hparaujo2808/armariodispensario/armario/mapas/CHAPA_22.png

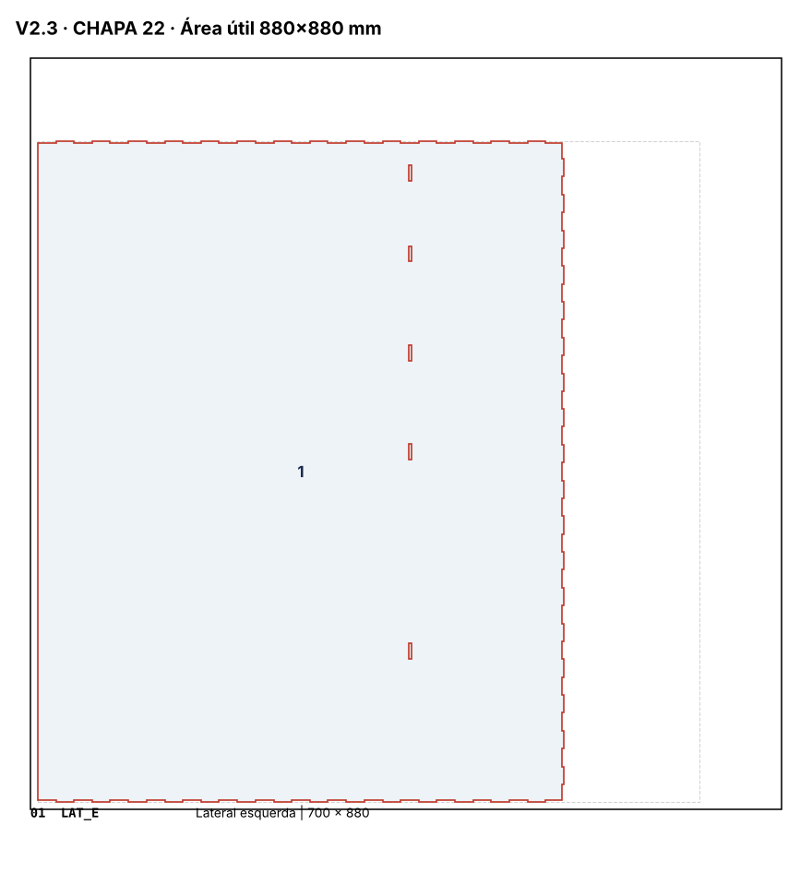
armario/mapas/CHAPA_22.png
