hparaujo2808/armariodispensario/armario/00_CUPOM_PORTA_NOMES.dxf

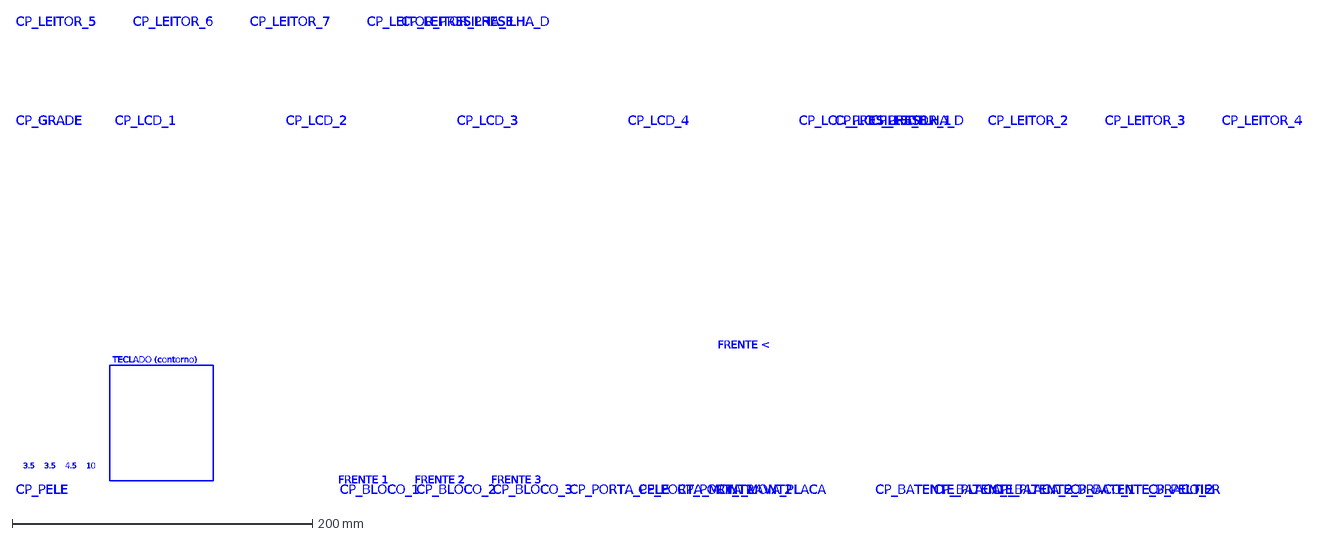
[picture p2: CAD file, 2026-10-23]
armario/00_CUPOM_PORTA_NOMES.dxf
CP_PELE
3.5
4.5
10
TECLADO (contorno)
CP_BLOCO_1
FRENTE 1
CP_BLOCO_2
FRENTE 2
CP_BLOCO_3
FRENTE 3
CP_PORTA_PELE
CP_PORTA_MONT1
CP_PORTA_MONT2
CP_TRAVA_PLACA
FRENTE <
CP_BATENTE_PLACA_1
CP_BATENTE_PLACA_2
CP_BATENTE_BRACO_1
CP_BATENTE_BRACO_2
CP_PELTIER
CP_GRADE
CP_LCD_1
CP_LCD_2
CP_LCD_3
CP_LCD_4
CP_LCD_PRESILHA_E
CP_LCD_PRESILHA_D
CP_LEITOR_1
CP_LEITOR_2
CP_LEITOR_3
CP_LEITOR_4
CP_LEITOR_5
CP_LEITOR_6
CP_LEITOR_7
CP_LEITOR_PRESILHA_E
CP_LEITOR_PRESILHA_D
