hparaujo2808/armariodispensario/armario/corte/CHAPA_24.dxf

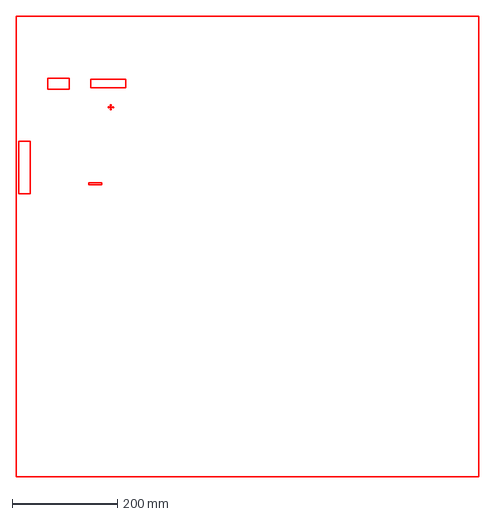
[picture p3: CAD file, 2026-10-23]
armario/corte/CHAPA_24.dxf
880.0 x 876.0 mm
