hparaujo2808/armariodispensario/armario/gravacao/CHAPA_26_NOMES.dxf

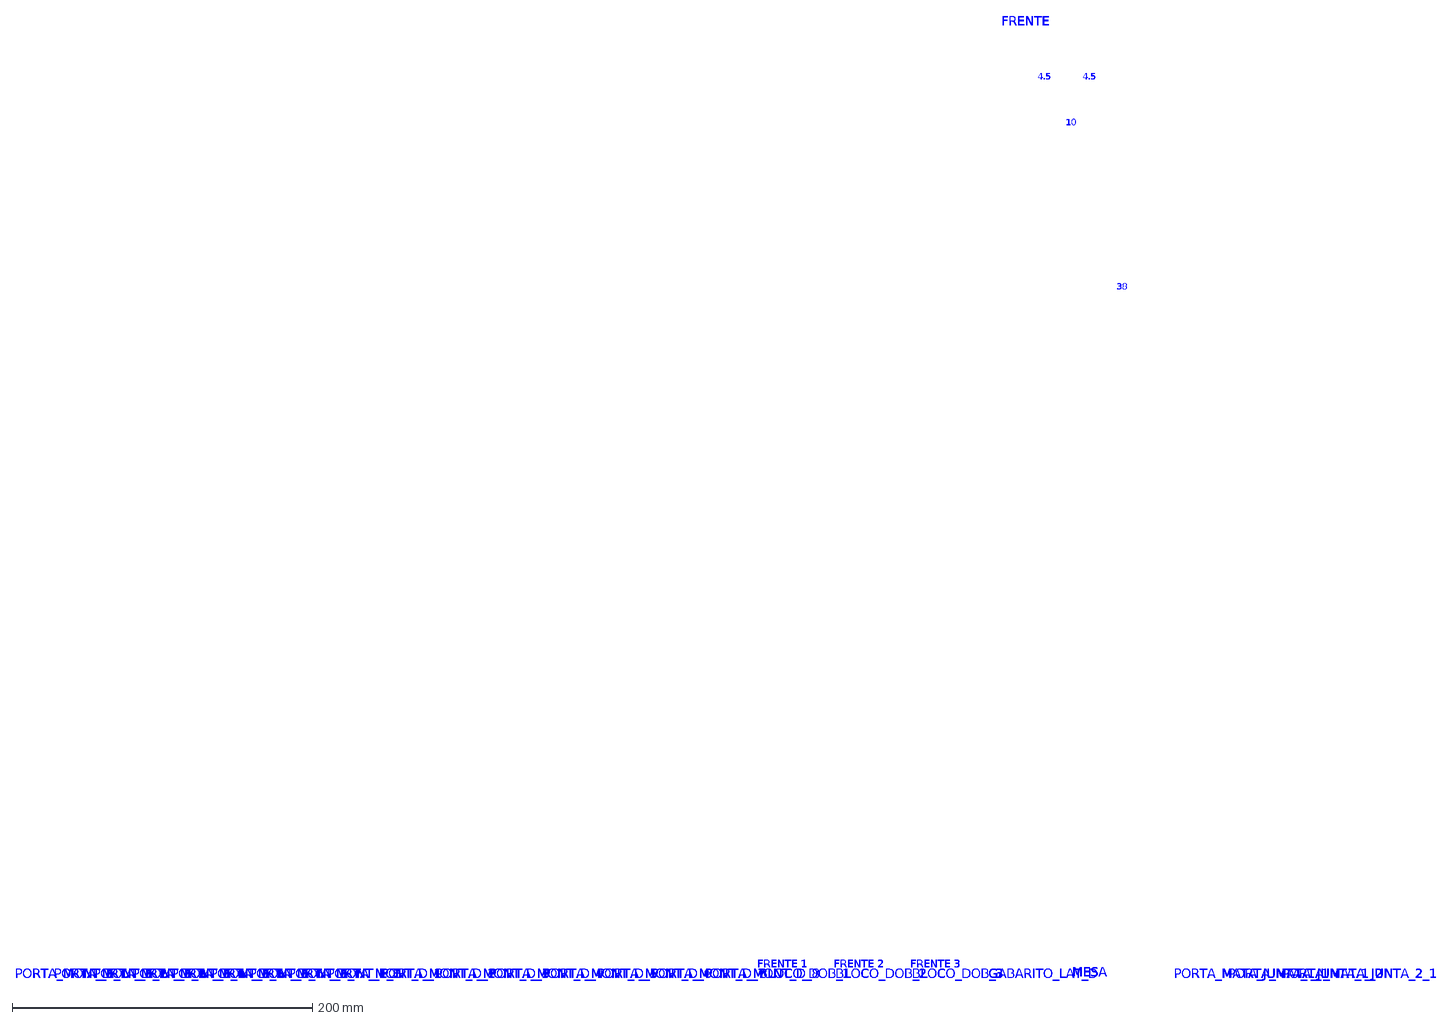
[picture p4: CAD file, 2026-10-23]
armario/gravacao/CHAPA_26_NOMES.dxf
PORTA_MONT_E_1
PORTA_MONT_E_2
PORTA_MONT_E_3
PORTA_MONT_E_4
PORTA_MONT_E_5
PORTA_MONT_E_6
PORTA_MONT_E_7
PORTA_MONT_E_8
PORTA_MONT_D_1
PORTA_MONT_D_2
PORTA_MONT_D_3
PORTA_MONT_D_4
PORTA_MONT_D_5
PORTA_MONT_D_6
PORTA_MONT_D_7
PORTA_MONT_D_8
BLOCO_DOB_1
FRENTE 1
BLOCO_DOB_2
FRENTE 2
BLOCO_DOB_3
FRENTE 3
GABARITO_LAT_D
4.5
10
38
FRENTE
MESA
PORTA_MATA_JUNTA_1_1
PORTA_MATA_JUNTA_1_2
PORTA_MATA_JUNTA_2_1
