hparaujo2808/armariodispensario/armario/00_CUPOM_PORTA_CORTE.dxf

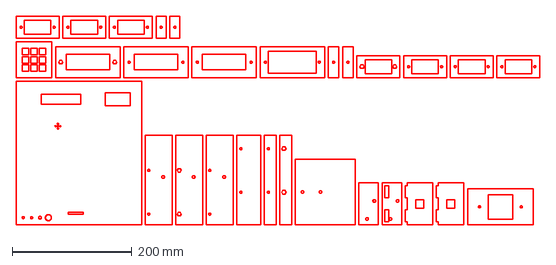
[picture p5: CAD file, 2026-10-23]
armario/00_CUPOM_PORTA_CORTE.dxf
876.0 x 349.0 mm
