hparaujo2808/armariodispensario/armario/corte/CHAPA_26.dxf

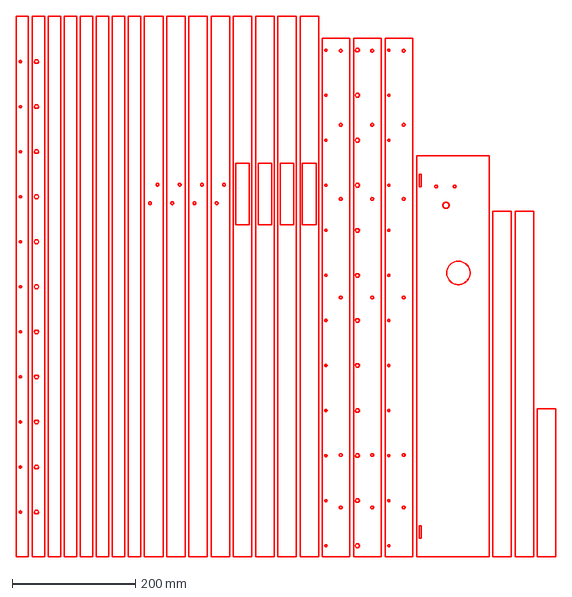
[picture p6: CAD file, 2026-10-23]
armario/corte/CHAPA_26.dxf
874.6 x 876.0 mm
