hparaujo2808/armariodispensario/armario/gravacao/CHAPA_25_NOMES.dxf

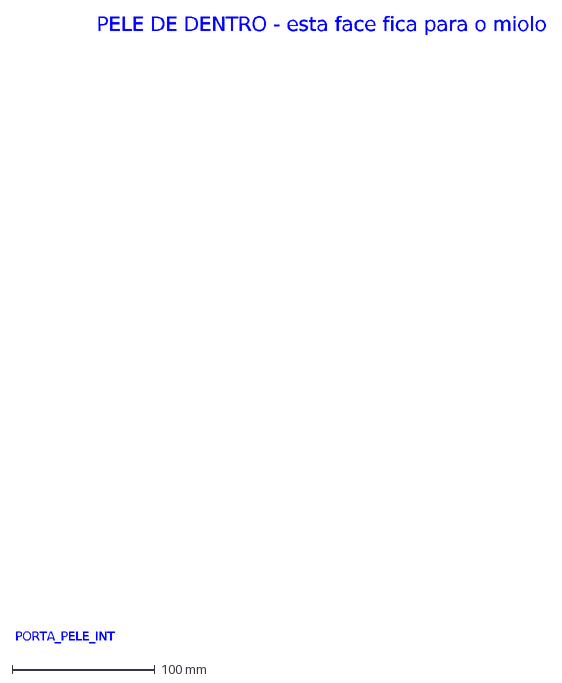
[picture p7: CAD file, 2026-10-23]
armario/gravacao/CHAPA_25_NOMES.dxf
PORTA_PELE_INT
PELE DE DENTRO - esta face fica para o miolo
