hparaujo2808/armariodispensario/armario/00_TESTES_CORTE.dxf

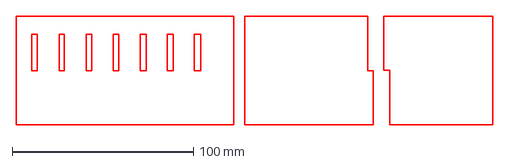
[picture p8: CAD file, 2026-10-22]
armario/00_TESTES_CORTE.dxf
263.0 x 60.0 mm
