hparaujo2808/armariodispensario/armario/corte/CHAPA_27.dxf

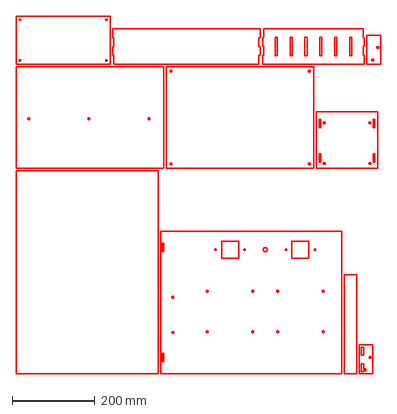
[picture p9: CAD file, 2026-10-23]
armario/corte/CHAPA_27.dxf
879.0 x 864.0 mm
