hparaujo2808/armariodispensario/armario/gravacao/CHAPA_24_NOMES.dxf

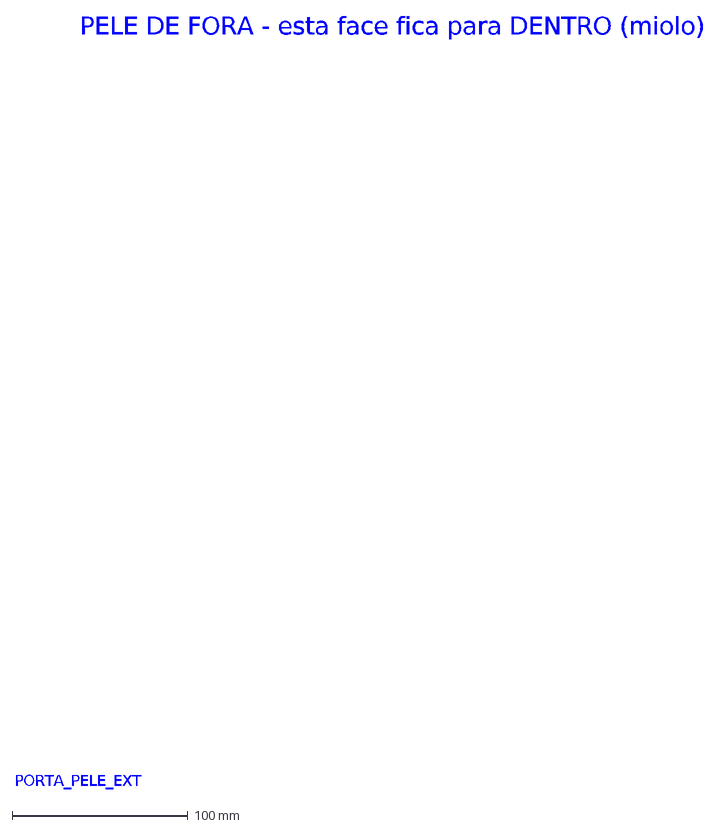
[picture p10: CAD file, 2026-10-23]
armario/gravacao/CHAPA_24_NOMES.dxf
PORTA_PELE_EXT
PELE DE FORA - esta face fica para DENTRO (miolo)
