hparaujo2808/armariodispensario/armario/00_TESTES_NOMES.dxf

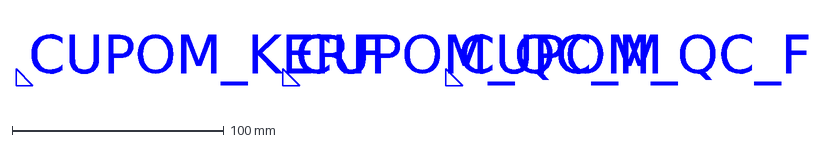
[picture p11: CAD file, 2026-10-22]
armario/00_TESTES_NOMES.dxf
CUPOM_KERF
CUPOM_QC_M
CUPOM_QC_F
