hparaujo2808/armariodispensario/armario/corte/CHAPA_25.dxf

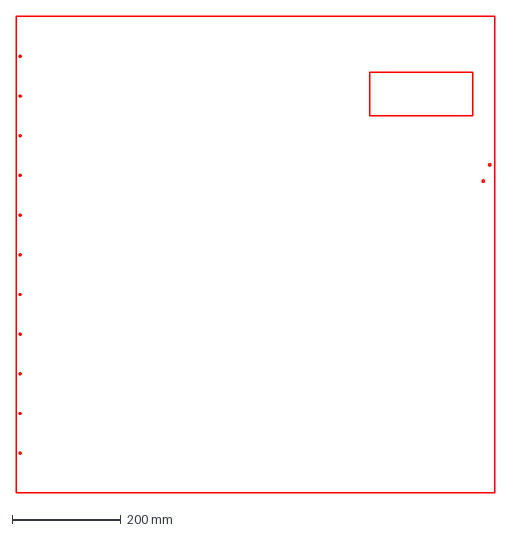
[picture p12: CAD file, 2026-10-23]
armario/corte/CHAPA_25.dxf
880.0 x 876.0 mm
