hparaujo2808/armariodispensario/armario/gravacao/CHAPA_28_NOMES.dxf

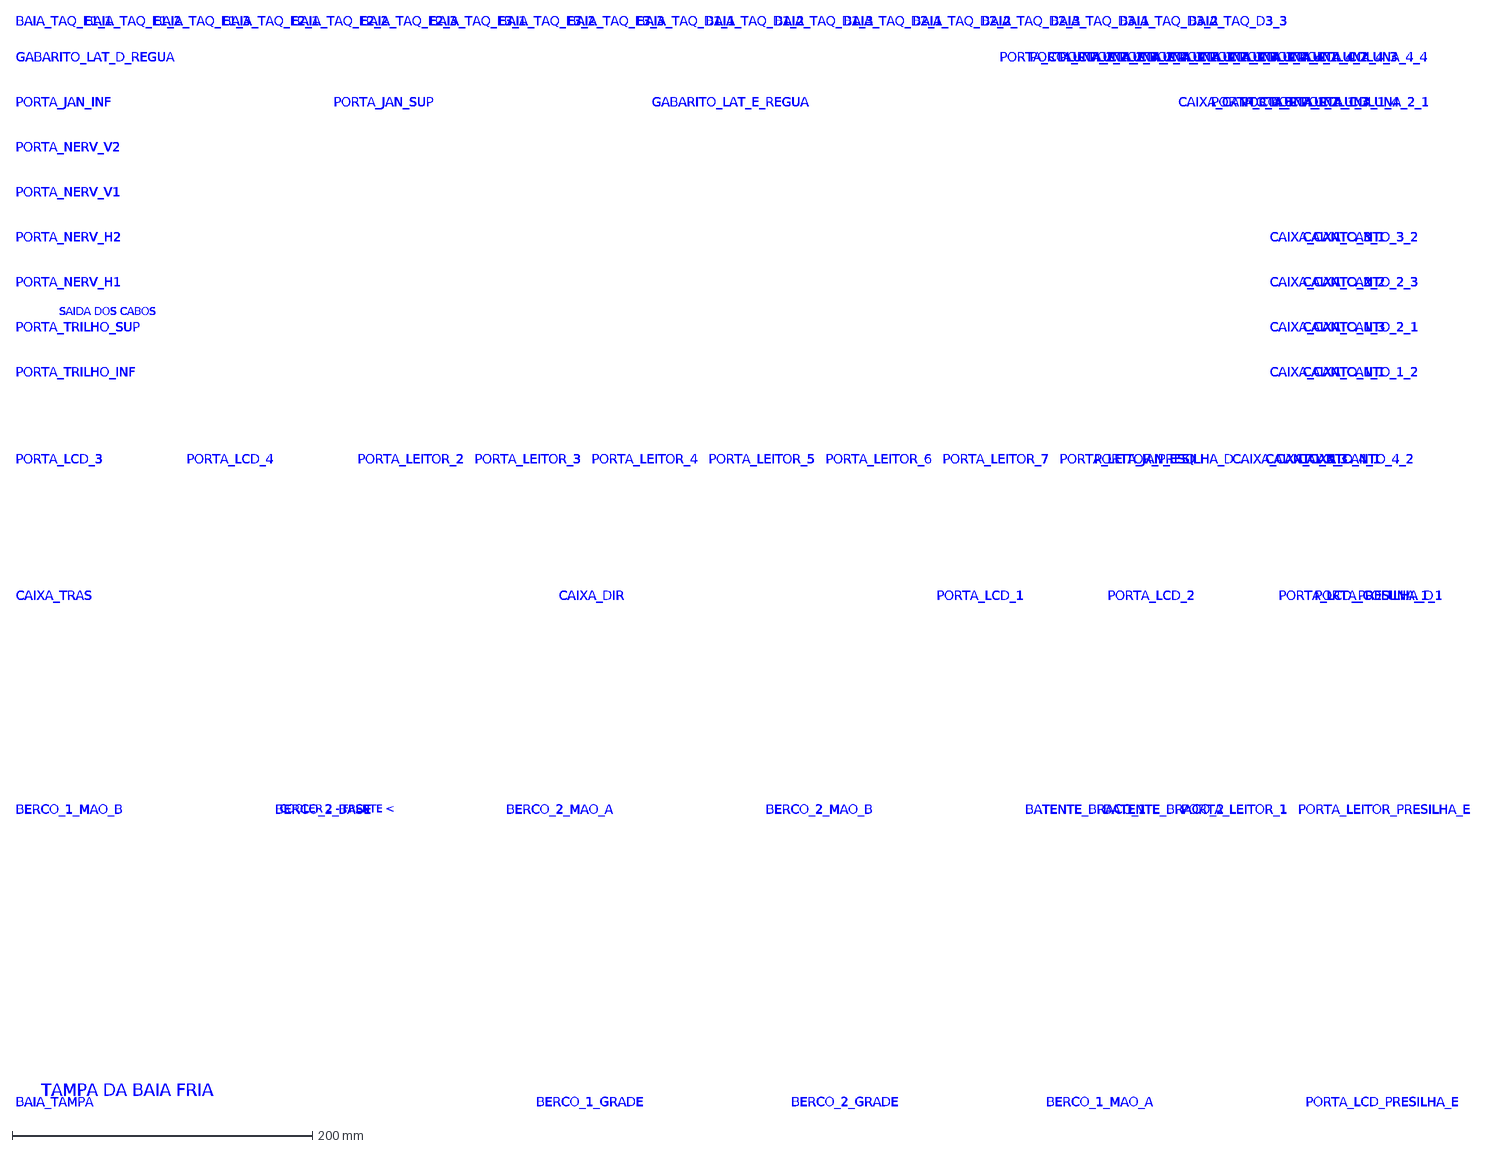
[picture p13: CAD file, 2026-10-23]
armario/gravacao/CHAPA_28_NOMES.dxf
BAIA_TAMPA
TAMPA DA BAIA FRIA
BERCO_1_GRADE
BERCO_2_GRADE
BERCO_1_MAO_A
BERCO_1_MAO_B
BERCO_2_BASE
COOLER 2 - FRENTE <
BERCO_2_MAO_A
BERCO_2_MAO_B
CAIXA_TRAS
CAIXA_DIR
BATENTE_BRACO_1
BATENTE_BRACO_2
PORTA_LCD_1
PORTA_LCD_2
PORTA_LCD_3
PORTA_LCD_4
PORTA_LCD_PRESILHA_E
PORTA_LCD_PRESILHA_D
PORTA_LEITOR_1
PORTA_LEITOR_2
PORTA_LEITOR_3
PORTA_LEITOR_4
PORTA_LEITOR_5
PORTA_LEITOR_6
PORTA_LEITOR_7
PORTA_LEITOR_PRESILHA_E
PORTA_LEITOR_PRESILHA_D
PORTA_TRILHO_INF
PORTA_TRILHO_SUP
SAIDA DOS CABOS
PORTA_NERV_H1
PORTA_NERV_H2
PORTA_NERV_V1
PORTA_NERV_V2
PORTA_JAN_INF
PORTA_JAN_SUP
PORTA_JAN_ESQ
GABARITO_LAT_E_REGUA
GABARITO_LAT_D_REGUA
CAIXA_CANTO_1_1
CAIXA_CANTO_1_2
CAIXA_CANTO_1_3
CAIXA_CANTO_2_1
CAIXA_CANTO_2_2
CAIXA_CANTO_2_3
CAIXA_CANTO_3_1
CAIXA_CANTO_3_2
CAIXA_CANTO_3_3
CAIXA_CANTO_4_1
CAIXA_CANTO_4_2
CAIXA_CANTO_4_3
PORTA_COLUNA_1_1
PORTA_COLUNA_1_2
PORTA_COLUNA_1_3
PORTA_COLUNA_1_4
PORTA_COLUNA_2_1
PORTA_COLUNA_2_2
PORTA_COLUNA_2_3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
