hparaujo2808/armariodispensario/armario/corte/CHAPA_28.dxf

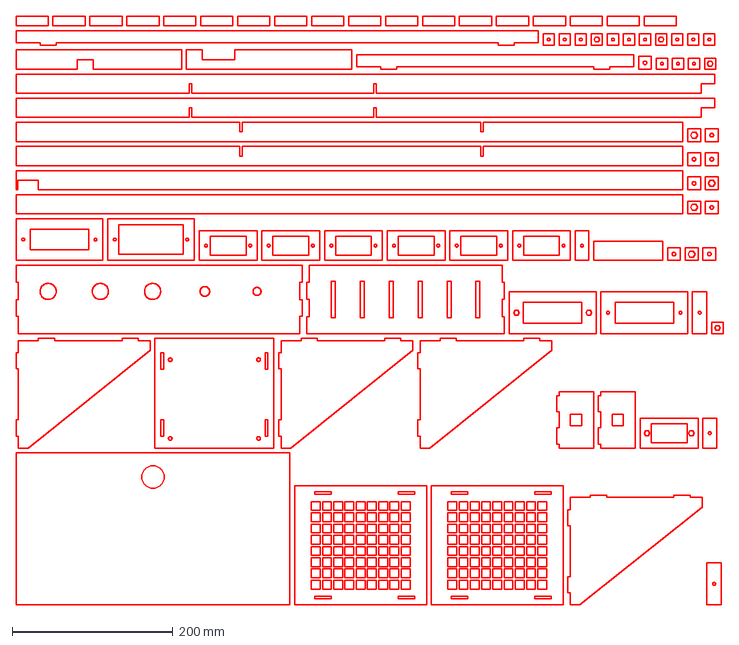
[picture p14: CAD file, 2026-10-23]
armario/corte/CHAPA_28.dxf
880.0 x 732.5 mm
