hparaujo2808/armariodispensario/armario/gravacao/CHAPA_27_NOMES.dxf

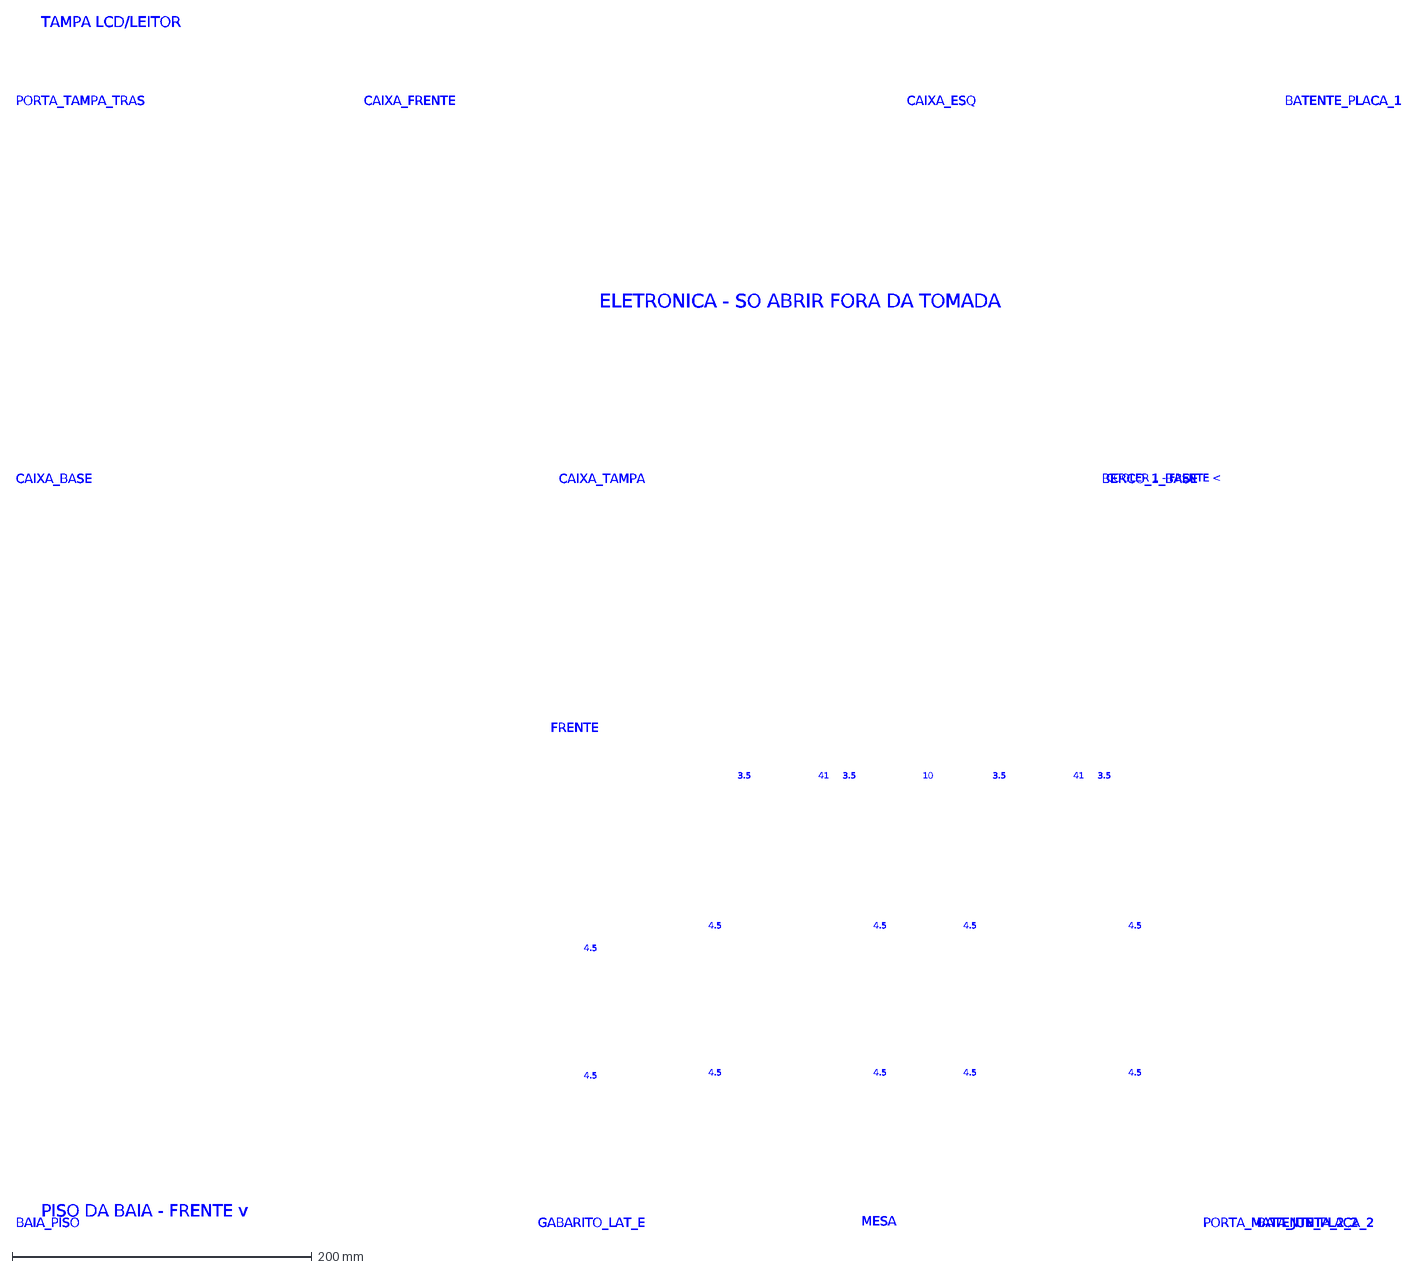
[picture p15: CAD file, 2026-10-23]
armario/gravacao/CHAPA_27_NOMES.dxf
BAIA_PISO
PISO DA BAIA - FRENTE v
GABARITO_LAT_E
41
3.5
4.5
10
FRENTE
MESA
CAIXA_BASE
CAIXA_TAMPA
ELETRONICA - SO ABRIR FORA DA TOMADA
PORTA_MATA_JUNTA_2_2
BERCO_1_BASE
COOLER 1 - FRENTE <
PORTA_TAMPA_TRAS
TAMPA LCD/LEITOR
CAIXA_FRENTE
CAIXA_ESQ
BATENTE_PLACA_1
BATENTE_PLACA_2
