hparaujo2808/armariodispensario/armario/corte/CHAPA_23.dxf

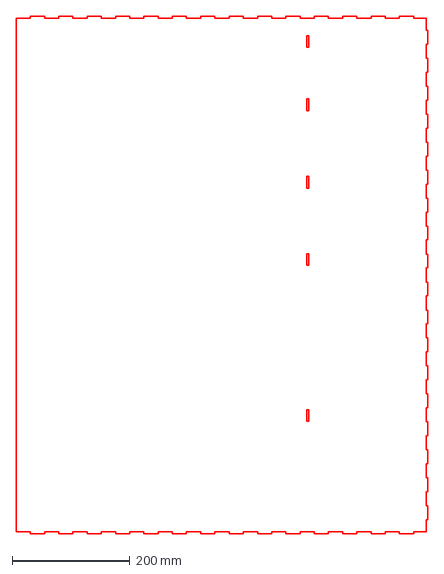
[picture p16: CAD file, 2026-10-22]
armario/corte/CHAPA_23.dxf
700.0 x 880.0 mm
