hparaujo2808/armariodispensario/armario/gravacao/CHAPA_22_NOMES.dxf

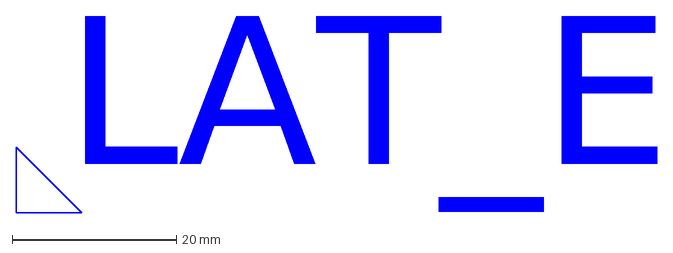
[picture p17: CAD file, 2026-10-22]
armario/gravacao/CHAPA_22_NOMES.dxf
LAT_E
