hparaujo2808/armariodispensario/armario/corte/CHAPA_22.dxf

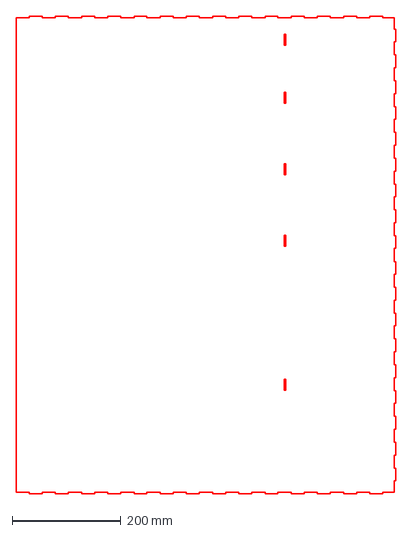
[picture p18: CAD file, 2026-10-22]
armario/corte/CHAPA_22.dxf
700.0 x 880.0 mm
