hparaujo2808/armariodispensario/armario/gravacao/CHAPA_23_NOMES.dxf

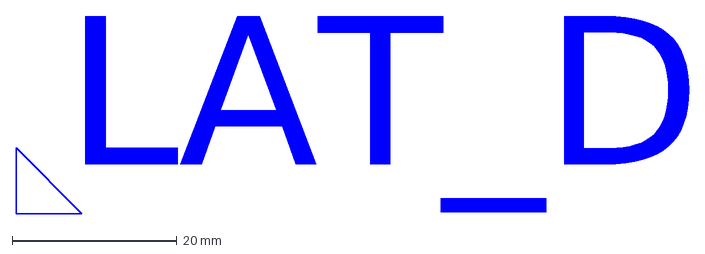
[picture p19: CAD file, 2026-10-22]
armario/gravacao/CHAPA_23_NOMES.dxf
LAT_D
