hparaujo2808/armariodispensario/armario/MONTAGEM_REFORCOS.md

# Posição das nervuras — v2

Olhe o armário de frente. Medidas em milímetros, a partir do canto externo
inferior esquerdo da frente: X aumenta para a direita, Y para o fundo, Z para
cima. As faixas incluem a espessura de 3mm da peça de referência.

Não há reforço colado de emenda nesta revisão: com a altura reduzida a
880mm, base, tampo, as duas laterais e os dois fundos cabem cada um
numa peça única — o projeto inteiro ficou sem nenhuma emenda de painel. A
única colagem estrutural que resta é nos cantos (dente reto) e nas nervuras
abaixo.

| Código | X: esquerda → direita | Y: frente → fundo | Z: baixo → cima |
|---|---:|---:|---:|
| NERV_P_CAM_1 | 3.0 a 877.0 | 80.8 a 83.8 | 756.0 a 794.0 |
| NERV_P_CAM_2 | 3.0 a 877.0 | 245.5 a 248.5 | 756.0 a 794.0 |
| NERV_P_CAM_3 | 3.0 a 877.0 | 410.2 a 413.2 | 756.0 a 794.0 |
| NERV_PRAT_1_1 | 3.0 a 877.0 | 80.8 a 83.8 | 624.3 a 662.3 |
| NERV_PRAT_1_2 | 3.0 a 877.0 | 245.5 a 248.5 | 624.3 a 662.3 |
| NERV_PRAT_1_3 | 3.0 a 877.0 | 410.2 a 413.2 | 624.3 a 662.3 |
| NERV_PRAT_2_1 | 3.0 a 877.0 | 80.8 a 83.8 | 492.7 a 530.7 |
| NERV_PRAT_2_2 | 3.0 a 877.0 | 245.5 a 248.5 | 492.7 a 530.7 |
| NERV_PRAT_2_3 | 3.0 a 877.0 | 410.2 a 413.2 | 492.7 a 530.7 |

As nervuras NERV entram nos rasgos da prateleira correspondente e são
coladas por baixo dela.

A tabela descreve posições calculadas parametricamente. Não substitui o
ensaio de montagem, a escolha das ferragens ou a avaliação de resistência e
estabilidade do conjunto.
