hparaujo2808/armariodispensario/(commit log)

2026-10-15 docs: README do projeto e lista de compras da eletrônica
    Decisões de hardware (Arduino Mega, LCD 16x2 I2C, teclado 4x4, trava
    solenoide 12 V, 2 Peltier, buzzer), estrutura de pastas e lista de
    compras com quantidade, função e faixa de preço de cada peça.
2026-10-15 docs: simulação 3D do armário com porta, pinpad e trava
    Página autocontida (three.js r128 via CDN) que mostra o protótipo
    pronto: porta proposta com LCD 16x2 e teclado 4x4, trava solenoide na
    parede direita com batente em L na porta, sensor reed, gavetas e as
    duas gavetas frias (C1 e C2) com Peltier. Inclui o corte visto de cima
    da lingueta chanfrada e a ficha da porta.
2026-10-16 docs: todos os fios, furos e mapa de pinos na simulação
    Cada cabo vira um tubo colorido no 3D com o caminho real: os da porta
    (teclado e LCD + buzzer, dois cabos de rede) com laço de folga na
    dobradiça que acompanha a porta, trava e sensor pela parede direita,
    Peltier, 12 V com fusível, GND, 5 V do LM2596, controle dos relés e
    tomada. Tabela clicável destaca cada cabo, mapa de pinos do Mega e os
    5 furos a fazer antes da cola. Buzzer passa para a caixa da porta.
2026-10-16 docs: diagrama de ligações e LIGACOES.md
    Diagrama no estilo das apostilas (Mega à esquerda, componentes à
    direita, 12 V em vermelho, GND comum) gerado por docs/gerar_diagrama.py.
    LIGACOES.md junta mapa de pinos, cabos com bitola e caminho, furos a
    fazer antes da cola e checagens antes de ligar na tomada. O diagrama
    também entra na simulação e no README.
2026-10-16 refactor: tira o sensor de porta, tranca só pelo teclado
    A trava de lingueta chanfrada tranca sozinha ao fechar, então o reed
    switch saiu do diagrama, das tabelas, da lista de compras e da
    simulação. A sessão agora termina pela tecla D (corta a trava se ainda
    estiver solta e bloqueia A e B) ou depois de 60 s sem tecla. A trava
    fica liberada por 5 s após a senha certa, com ou sem a porta aberta.
2026-10-16 feat: nome da peça ao passar o mouse na simulação; Peltier sem cooler
    Etiqueta com nome e detalhe de cada peça, fio e furo sob o cursor (no
    toque, aparece no tap). No raio-X o MDF é ignorado e dá pra apontar a
    eletrônica. O grupo não vai comprar cooler: a Peltier fica só com
    dissipador de alumínio passivo na simulação, no diagrama e na lista.
2026-10-16 docs: Peltier em furo de 38 mm, sem recorte no MDF
    O MDF já está todo cortado. As pastilhas saem do recorte 40 x 40 e vão
    para o vão de trás, tampando um furo de 38 mm (serra copo) no fundo
    falso, presas por abraçadeira em dois furinhos de 5 mm.
2026-10-19 refactor: sem bornes e LCD 16x1 em paralelo
    12 V vai do fusível pro COM 1 e passa de COM em COM; GND direto nos
    parafusos V- da fonte, dois fios por parafuso. LCD 16x1 sem I2C nos
    pinos 38 a 48, com potenciômetro de contraste; simulação em uma linha.
2026-10-21 docs: lista de compras com links; kit TEC1-12703 + fonte 10 A + fusível 10 A
2026-10-21 docs: lista inclui jumpers, fio de 0,5 mm² e cabo de rede da porta
2026-10-21 docs: coluna "Para quê" na lista de compras
2026-10-22 feat: câmera no compartimento de cima e link da simulação no README
    Webcam USB olhando para a porta por um furo de 15 mm, cabo pelo fundo
    falso e traseiro (furos de 16 mm) até o notebook. Simulação, LIGACOES,
    lista de compras e README atualizados. docs/index.html redireciona para
    a simulação (GitHub Pages).
2026-10-22 fix: LCD é 16x2, não 16x1
    Simulação mostra duas linhas (aviso em cima, detalhe embaixo) em vez de
    alternar telas; LIGACOES troca lcd.begin(8, 2) por lcd.begin(16, 2).
    Fiação não muda.
2026-10-22 calc: conferência térmica do kit atual e da geometria contra a V2.3
    termico_atual.py mostra que a TEC1-12703 com dissipador passivo passa de
    125 °C no lado quente e não esfria a gaveta. conferir_geometria.py calcula
    as posições a partir do config.py da V2.3 e acha C1/C2 trocadas e a rota
    dos cabos da porta cruzando as nervuras.
2026-10-22 fix(armario): traz o gerador da V2.3 para o repo e faz ele rodar
    O config.py da V2.3 deixava PECAS_JA_CORTADAS = None e o main.py quebrava.
    Agora a lista é calculada a partir de CORTAR_NA_MAQUINA. O gerador não
    regera mais o LEIA_PRIMEIRO.md (o modelo ainda era o texto da v2.1) e o
    VALIDACAO.json usa a versão do config. Os DXFs do repo são os originais
    cortados; tests/test_armario.py confere que o gerador os reproduz entidade
    por entidade e que o LEIA_PRIMEIRO.md fica intacto.
    [00_TESTES_CORTE.dxf, 00_TESTES_NOMES.dxf, CHAPA_22.dxf, CHAPA_22_NOMES.dxf, CHAPA_23.dxf, CHAPA_23_NOMES.dxf, LISTA_PECAS.csv]
2026-10-22 calc: opções de gaveta fria, encaixe dos coolers e ventilação do vão de trás
    gaveta_fria.py compara a baia C2 e a baia A3+A4 com 1 ou 2 TEC1-12703 e
    25/40/50 mm de XPS. vao_de_tras.py confere o Hyper 212 (124 x 73 x 152 mm)
    nos 200 mm do vão e calcula 8 + 8 furos de 38 mm no traseiro.
    conferir_geometria.py passa a ler armario/gerador/config.py.
2026-10-22 docs: decisão 1 (Mega + notebook, baia fria A3+A4) e lista do que falta comprar
    DECISOES.md registra a arquitetura híbrida, a baia fria fixa na coluna A
    com 2 TEC1-12703 e EPS 50 mm (6,7 L; 5,5 °C a 32 °C), o controle com
    histerese e corte abaixo de 2 °C, o encaixe dos coolers e os furos de
    ventilação, e o Mega na USB do notebook.
    LISTA-DE-COMPRAS.md vira a lista do que falta, com links e preços
    conferidos em 22/10 (R$ 460,81 confirmados + ~R$ 165 estimados). A
    lista de 21/10 foi para legado/ com um LEIA_ME.
2026-10-22 feat(hardware): mapa de pinos e potência em fonte única, LIGACOES.md gerado
    hardware/pinos.yaml e hardware/potencia.yaml são a única fonte de pinos,
    fios, bitolas e fusíveis. hardware/gerar.py valida (pino repetido ou
    reservado, PWM/interrupção/Serial1, corrente x bitola x fusível) e gera
    o pinos.h do firmware, as tabelas do docs/LIGACOES.md e os diagramas de
    sinal e de potência. hardware/furos.py calcula os furos a partir do
    config.py e confere choque com rasgos, prateleiras, nervuras e bordas.
    tests/test_pinos.py falha se algo divergir.
    LIGACOES.md reescrito para a decisão 1: Mega na USB, AS608 na Serial1,
    reed de volta, 3 DS18B20, 2 Peltier com cooler e fusível térmico, F2 no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
2026-10-22 docs: roteiro de testes de bancada e checklist de segurança
    TESTES_DE_BANCADA.md vai do mais seguro (medições em Ω sem energia) ao
    mais arriscado (30 min com as duas Peltier), com o valor esperado de
    cada medição e o que fazer se der diferente. SEGURANCA.md tem o checklist
    antes de ligar na tomada, os riscos de cada parte e o que nunca fazer.
2026-10-22 fix(baia): coolers por fora da lateral esquerda e eletrônica no tampo (armário já colado)
    No pior caso pedido pelo grupo (traseiro, fundo falso e corrediças já
    colados), o vão de trás não tem acesso: não cabe pôr lá os coolers, o
    Mega, os relés nem a fonte. As Peltier passam a atravessar a lateral
    esquerda (parede da baia A3+A4), com os coolers do lado de fora em berços
    parafusados (peso fora da prensa), ventoinha embaixo soprando para cima.
    A eletrônica vai numa caixa no tampo, que também cobre o borne da fonte.
    Só há furos nas laterais, feitos por fora com gabarito.
    hardware/layout.py concentra as posições; calculos/coolers_externos.py
    confere corrediças, apoio (3,1 N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
2026-10-22 feat(porta): Fase 5 — cupom de teste, porta-caixão, gabaritos, colisão e manual
    Gerador v2.4 em armario/gerador (porta.py, porta_main.py, porta_colisao.py,
    manual_porta.py), com os parâmetros no mesmo config.py da V2.3 e chapas a
    partir da CHAPA_24. Não altera as chapas 22–23 nem o LEIA_PRIMEIRO.
    - 00_CUPOM_PORTA_*.dxf (29 peças): recortes do LCD, leitor, teclado e
    buzzer, trecho da dobradiça com bloco e porcas presas, batente com placa
    da trava, furo da Peltier e grade do berço.
    - CHAPA_24–28 (120 peças): porta-caixão 880 × 876 × 30 mm (4,7 kg), bloco
    da dobradiça piano, batente com liberação de emergência pela cava do
    puxador, mata-junta, berços dos coolers,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
    [00_CUPOM_PORTA_CORTE.dxf, 00_CUPOM_PORTA_NOMES.dxf, CHAPA_24.dxf, CHAPA_24_NOMES.dxf, CHAPA_25.dxf, CHAPA_25_NOMES.dxf, CHAPA_26.dxf, CHAPA_26_NOMES.dxf]
2026-10-22 feat(firmware): Fase 3 — firmware do Mega com lógica testada no PC
    - src/logica (C++ sem Arduino.h): máquina de estados não bloqueante
    (digital ou ID+senha, espera o CPF no notebook ou libera sozinha, porta
    aberta/fechada, bloqueio após 3 erros, alarme de porta aberta, abertura
    sem autorização, recuperação após reset), controle térmico (histerese,
    tempos mínimos, cortes de congelamento, sensor e lado quente, partida
    escalonada, pausa durante a trava), fila de 200 eventos na EEPROM com
    número de sequência, 20 usuários com SHA-256 da senha, protocolo texto
    com CRC-8 e reenvio até ACK.
    - armario_dispensador.ino: saídas seguras antes de pinMode, watchdog de
    2 s,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
    [armario_dispensador.ino, comum.cpp, maquina.cpp, maquina.h, memoria.cpp, memoria.h, parametros.h]
2026-10-22 feat(app): Fase 4 — app do notebook com o Mega (real ou simulado)
    Reaproveita do legado o banco (auditoria somente-inserção com hash
    encadeado, CPF só como pseudônimo), o MV simulado e o painel. Novo:
    núcleo guiado pelos eventos do Mega (AUTH_OK -> CPF -> LIB -> porta ->
    confirmação), HAL serial_mega.py e mega_simulado.py, gravação das 2
    câmeras por abertura com SHA-256, eventos do Mega sem duplicar, senha da
    porta e cadastro de digital pelo painel, python -m app [--sim].
    tests/test_app.py (18) + vetor de CRC comum ao firmware.
2026-10-23 docs: README novo, simulação 3D gerada do config e ajuste do quiosque
    - README reescrito: o que é, arquitetura, como rodar (python -m app
    [--sim]), usuários de demonstração, roteiro da banca ligado aos RF/RNF,
    fora do escopo e situação real de cada parte.
    - docs/simulacao.html agora é gerada por docs/gerar_simulacao.py a partir
    de config.py e layout.py (porta de 30 mm, baia fria, coolers por fora,
    gavetas com 1 embaixo, câmeras e caixa no tampo); teste confere. A versão
    de 21/10 foi para legado/.
    - Quiosque: layout em coluna, o cabeçalho e os alarmes não somem quando a
    barra de simulação quebra em duas linhas (achado no teste no navegador).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
2026-10-23 docs: auditoria com a situação de cada item em 23/10
2026-10-23 firmware: relés na ordem certa, baia que não esfria, leitor sem erro repetido e janela de abertura
    Correções da revisão independente (itens 9, 11, 13, 15, 16 e 25) e modo autônomo configurável.
2026-10-23 docs: relés desligados sem o Mega, furos da trava, tabela da baia fria e revisão na auditoria
    Correções da revisão independente (itens 1, 12, 17, 19 a 24, 31, 32 e 34) e seção 10 da auditoria com o que ficou em aberto.
    [00_CUPOM_PORTA_CORTE.dxf, 00_CUPOM_PORTA_NOMES.dxf, CHAPA_24.dxf, CHAPA_24_NOMES.dxf, CHAPA_25.dxf, CHAPA_25_NOMES.dxf, CHAPA_26.dxf, CHAPA_26_NOMES.dxf]
